tristancode/kona-3d-prints/reference/photos/front-v1-test-print.jpg

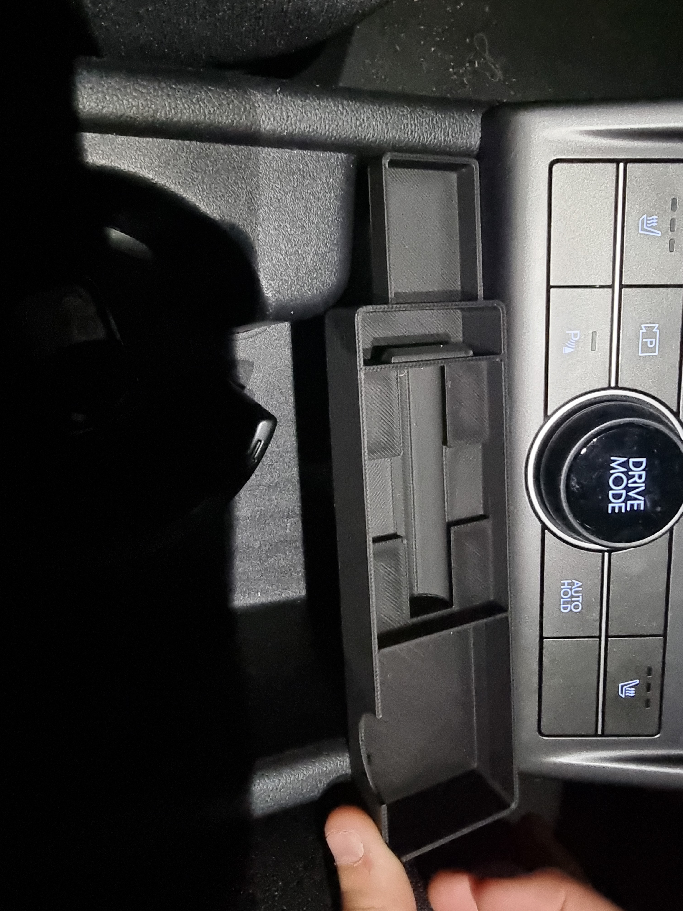
reference/photos/front-v1-test-print.jpg
