tristancode/kona-3d-prints/docs/decisions.md

# Decision log

One line per decision, in date order. The linked conversation record has the context.

| Date | Decision | Source |
|---|---|---|
| 2026-09-27 | Trays are generated from parametric CadQuery scripts; print files and pictures are outputs, never edited by hand | [rear tray conversation](conversations/2026-09-27-rear-console-tray.md) |
| 2026-09-27 | Low profile to save filament: 20 mm tall, 1.6 mm walls, 1.0 mm floor, no supports | rear tray conversation |
| 2026-09-27 | Lip balm taken as a Burt's Bees tube, 15.3 × 68 mm: 15.7 mm channel, 13.8 mm snap opening, closed ends | rear tray conversation |
| 2026-09-27 | Rear tray front is the short end Charlimit circled; two cradles across it, parallel to the front wall | rear tray conversation |
| 2026-09-27 | Rear bin floor: 190 long, 120 wide for the back 120 mm, 135 at the front; tray clearance 0.75 per side, 1.5 per end | rear tray conversation |
| 2026-09-27 | One 24 mm U finger notch behind the cradles | rear tray conversation |
| 2026-09-27 | One half-pencil lift ridge on the back of the cradle wall, nearer the middle; side tabs dropped | rear tray conversation |
| 2026-09-27 | Fob pocket 58 × 40 mm, straight sided, for a 55 × 33 mm fob | rear tray conversation |
| 2026-09-27 | Every render includes measurements on each edge | rear tray conversation |
| 2026-10-12 | Front tray locates with a tongue in the 31.0 × 39.8 mm slot; fob on the right, balm to its left | [front tray conversation](conversations/2026-10-12-front-console-tray.md) |
| 2026-10-12 | Front strip width assumed 44 mm until measured | front tray conversation |
| 2026-10-12 | One repo for all Kona prints, one folder per part, one commit per version (`<part>: vN - ...`), tagged `<part>-vN` | [repo conversation](conversations/2026-10-12-repo-setup.md) |
| 2026-10-12 | Conversations stored as records plus the visible messages, as in `pizza-oven` | repo conversation |
| 2026-10-13 | Front tray v2: overall length = caliper 156.6 + 5 = 161.6 mm; 13 mm tall throughout (lowest the balm snap allows) | [front tray conversation](conversations/2026-10-12-front-console-tray.md) |
| 2026-10-13 | Front tray: finger well removed; half-pencil lift nub on the inside of the fob pocket's outer wall | front tray conversation |
| 2026-10-16 | Front tray v3: tab 27.5 mm, 159.6 mm long; balm in an open straight-sided half-cylinder trough (no snap) against the panel side; fob floor tilted 6° to the right end | [front tray conversation](conversations/2026-10-12-front-console-tray.md) |
| 2026-10-16 | Front tray v4: both end faces taper 10° (longer at the top) instead of a tilted fob floor; grip notch through both trough walls | [front tray conversation](conversations/2026-10-12-front-console-tray.md) |
| 2026-10-16 | Front tray v5: right end angled in plan (5 mm), balm on the cupholder side with finger space at the panel, no wide strip beside the balm, end taper 5° | [front tray conversation](conversations/2026-10-12-front-console-tray.md) |
| 2026-10-16 | Front tray v6: no finger space; balm trough walls are the outer walls; one shared wall between the trough and the fob pocket | [front tray conversation](conversations/2026-10-12-front-console-tray.md) |
| 2026-10-16 | Printing: Claude slices on the user's PC but does not imitate Bambu's signed print-start; the user presses Print in Bambu Studio unless LAN Only + Developer Mode is on. The printer access code is never stored or committed | [front tray conversation](conversations/2026-10-12-front-console-tray.md) |
