tristancode/kona-3d-prints/docs/conversations/2026-10-12-front-console-tray.md

# Conversation record – front console tray v1 to v6

| | |
|---|---|
| **Dates** | 2026-10-12, 15:20 to 15:27 Sydney time (04:20 to 04:27 UTC); 2026-10-13, 16:44 to 17:00 Sydney (05:44 to 06:00 UTC); 2026-10-16, 15:43 to 17:46 Sydney (04:43 to 06:46 UTC) |
| **Area** | front tray (the strip between the cupholders and the drive-mode panel) |
| **Claude project** | "Kona 3d print organiser", thread "Front console organiser" (claude.ai, cloud session) |
| **People** | Charlimit, Claude |
| **Status** | v1 and v2 test printed. v6 printing on 2026-10-16, fit not yet checked |
| **Type** | Record (summary written by Claude, not a verbatim transcript). The visible messages are in [`raw/2026-10-12-front-console-tray.md`](raw/2026-10-12-front-console-tray.md) |

## Summary
Charlimit asked for a second organiser, similar to the rear tray, for the front of the console: the key fob holder on the right, lip balm to its left, and a tongue in the narrow space on the left so it cannot move. Four photos came with it, with caliper and tape readings (`reference/photos/front-strip-01.jpg` to `-04.jpg`).

Claude wrote it the same way as the rear tray: a CadQuery script, `front-tray/kona_front_organiser.py`, plus `render_front.py` for the 3D preview and the dimensioned top view.

Layout, left to right: a 38.3 × 29.5 × 10 mm locating tongue that drops into the slot (0.75 mm clearance each side), a 12.8 mm finger well with a half-pencil lift ridge, one snap-in lip balm cradle lying lengthways, and a 58 × 40.8 mm fob pocket with straight sides. Main body 147 × 44 × 20 mm, 185.3 mm long with the tongue.

On 2026-10-13 Charlimit test printed v1 (`reference/photos/front-v1-test-print.jpg`). The tongue went into the slot and the 44 mm width fitted, but the tray was too long. They measured the strip at 156.6 mm with the calipers (`front-strip-length-caliper.jpg`) and asked for v2: the length should be the caliper reading plus 5 mm, remove the finger pocket, put the nub on the wall of the remote section, drop the height as much as possible, and make the left section the same height as the rest.

v2 is 161.6 mm overall (123.3 mm wide section plus the 38.3 mm narrow section) and 13 mm tall throughout, which is as low as the lip balm snap allows. The finger well and the fob finger scoop are gone. The cradle now starts inside the narrow section, off-centre towards the panel side, and leaves a 27.4 mm bin at the far left. The half-pencil nub is on the inside of the fob pocket's outer long wall and protrudes 3.5 mm, leaving 37.3 mm for the 33 mm fob.

On 2026-10-16 Charlimit test printed v2 (`reference/photos/front-v2-test-print-01.jpg` to `-04.jpg`) and asked for rework: the left tab was about 2 mm too wide, the overall width was about 2 mm too long, the key fob container needed to angle to the right, and the lip balm needed to move forward for more finger space. The balm sides should also be straight. They curved in at the top, so the balm didn't fit, and should be only a half cylinder.

v3: the narrow section is 27.5 mm (1.75 mm clearance per side), and the tray is 2 mm shorter overall (159.6 mm). "Width too long" was read as the length, since the width is set by the fob pocket and the cupholder side is open floor. The balm now sits in an open half-cylinder trough with straight sides and no snap, pushed against the drive-mode-panel side (forward in the car), with about 22 mm of open floor beside it for fingers. The fob pocket floor tilts 6° down towards the right-hand end. Claude posted a decision card offering a tilt towards the panel or a diagonal pocket instead.

Charlimit then marked up the v3 top view (`reference/photos/front-v3-markup-taper.png`). They drew a U cross-section for the trough, scribbled over both trough walls at the grip notch, and drew a side view tapering at both ends. They added: "It's not the floor that needs to tilt, but the sides need to taper. See photos of how it doesn't fit on the right." v4 tapers both end faces 10° (top 159.6 mm, floor 155.0 mm), makes the fob floor flat again, and cuts the grip notch through both trough walls.

Charlimit marked up v4 (`reference/photos/front-v4-markup.png`): "Still wrong... Right hand side there is an angle on the right side, not straight. Move the lip balm down the page so there is finger space against the car, also remove the section below the lip balm, nothing will fit in it so wasted space/filament. Reduce the taper on the sides to 5 degrees." v5: the right end is angled in plan (5 mm shorter on the cupholder side, read from the red line), the balm trough is against the cupholder-side wall with 7 mm of finger space on the panel side, the tray is only 27.5 mm wide from the left end to the fob pocket, and the end tapers are 5°. The fob pocket grew to 64/59 mm so the 55 mm fob still fits; the bin shrank to 19 mm.

Charlimit then asked to remove the 7 mm finger space and use the lip balm walls to join the sections, and said the balm's right-hand wall looked separate from the fob pocket's left wall when it should be continuous so it prints correctly. v6 makes the trough's side walls the outer walls (balm section 18.9 mm wide) and gives the trough and fob pocket one shared wall.

On 2026-10-16 Charlimit asked how much PLA v6 needs (Claude estimated 16 to 19 g from the 15.1 cm³ volume) and then asked Claude to send it straight to the printer using the LAN access code. Claude started a session on Charlimit's PC, which sliced v6 in Bambu Studio's engine (P1S 0.4 mm, Generic PLA, 0.2 mm layers, 3 walls, 15% gyroid, textured PEI at 60 °C: about 29 min and 17.3 g, `sliced\kona_front_organiser_v6.gcode.3mf` on the PC). The P1S rejected a third-party print start (error 84033543) because it isn't in LAN Only + Developer Mode, and Claude would not imitate Bambu's signed commands, so Charlimit cleared an old print off the plate and pressed Print in Bambu Studio. Filament left after the print: about 799 g if 888 g was on the spool before the last 72 g print, or about 871 g if 888 g was the figure after it. The access code was not stored or committed.

## Decisions

| Date | Decision |
|---|---|
| 2026-10-12 | Read from the photos: the narrow slot is 31.0 mm across and 39.8 mm along (calipers); the main floor is about 150 mm long (tape). |
| 2026-10-12 | Assumed, not measured: the strip width. The body is 44 mm, the least that holds the 40 mm fob pocket and its walls (`BODY_W`). |
| 2026-10-12 | Assumed: the slot is at the same floor level as the strip and flush with the drive-mode-panel side (`TONGUE_OFFSET`). |
| 2026-10-12 | Same lip balm cradle and half-pencil ridge as the rear tray; one cradle. |
| 2026-10-13 | Test print: the 44 mm width and the slot tongue fit. Overall length = caliper 156.6 + 5 = 161.6 mm, as Charlimit asked (`OVERALL_L`). |
| 2026-10-13 | Height 13 mm throughout, set by the lip balm cradle (12.6 mm); left section the same height. |
| 2026-10-13 | No finger well and no scoop; the lift nub is on the inside of the fob pocket's outer long wall. |
| 2026-10-13 | Cradle runs into the narrow section to fit the shorter length; a small bin fills the rest. |
| 2026-10-16 | Narrow section 27.5 mm (`CLEAR_SLOT` 1.75); overall 159.6 mm ("width too long" read as length). |
| 2026-10-16 | Lip balm in an open half-cylinder trough with straight sides, no snap; against the panel side with open finger space beside it. |
| 2026-10-16 | v3 placeholder: fob floor tilted 6°. Replaced in v4. |
| 2026-10-16 | v4: both end faces taper 10° from vertical (top 159.6, floor 155.0); the angle is Claude's default, read from the drawing. |
| 2026-10-16 | v4: grip notch through both trough walls; fob floor flat. |
| 2026-10-16 | v5: right end angled in plan, 5 mm shorter on the cupholder side (Claude's reading of the red line). |
| 2026-10-16 | v5: balm trough against the cupholder side; finger space against the panel; no wide strip beside the trough; end taper 5°. |
| 2026-10-16 | v6: no finger space; trough side walls are the outer walls; one shared wall between the trough and the fob pocket. |
| 2026-10-16 | Printing: slice on the PC, but start the print from Bambu Studio; no imitation of Bambu's signed commands, and the access code is never stored. |

## Deliverables and versions

| Tag | Time (UTC) | What |
|---|---|---|
| front-v1 | 2026-10-12 04:26 | Script, render script, STL, 3MF, STEP, preview and dimensioned top view, README. The committed files are the originals |
| front-v2 | 2026-10-13 05:58 | 161.6 mm long, 13 mm tall, no finger well, nub in the fob pocket |
| front-v3 | 2026-10-16 05:05 | Tab 27.5 mm, 159.6 mm long, open balm trough with finger space, fob floor tilted |
| front-v4 | 2026-10-16 05:15 | Ends taper 10°, two-sided grip notch, fob floor flat |
| front-v5 | 2026-10-16 05:30 | Angled right end, balm on the cupholder side, narrow body beside the balm, 5° taper |
| front-v6 | 2026-10-16 05:25 | Finger space removed, trough walls are outer walls, shared wall with the fob pocket |

## Open questions
- Whether 5 mm is the right amount of angle on the right end.

## Follow-ups
- Check v6's fit in the car (printed 2026-10-16).
