tristancode/kona-3d-prints/docs/conversations/2026-09-27-rear-console-tray.md

# Conversation record – rear console tray v1 to v11

| | |
|---|---|
| **Dates** | 2026-09-27, 20:55 to 22:31 Sydney time (10:55 to 12:31 UTC) |
| **Area** | rear tray (the bin under the armrest) |
| **Claude project** | "Kona 3d print organiser", thread "Kona console organiser design" (claude.ai, cloud session) |
| **People** | Charlimit, Claude |
| **Status** | v11 is current. Not yet test printed or test fitted |
| **Type** | Record (summary written by Claude on 2026-10-12, not a verbatim transcript). The visible messages are in [`raw/2026-09-27-rear-console-tray.md`](raw/2026-09-27-rear-console-tray.md) |

## Summary
Charlimit asked for a centre console organiser for a 2025 Hyundai Kona, printable on a Bambu Lab printer, low to save filament, and built around a lip balm that must not roll or rattle. Seven photos of the bin floor with a tape measure came with the request.

No CAD program was available, so Claude wrote the tray as a CadQuery script (`rear-tray/kona_organiser.py`) whose numbers sit at the top, and exported STL, 3MF and STEP from it with a 3D preview render.

The design then went through ten rounds of changes in about 90 minutes:

- **v1.** 187 × 123 × 20 mm rectangle, two snap-in lip balm cradles along a long wall, a key/coin pocket, a main bay and a side card bay, finger scoops at both ends.
- **v2.** "The front is the narrowest edge", corrected to "the wide edge": cradles moved to run end to end along a long edge, key pocket at the end of the row, two bays.
- **v3.** Charlimit circled the short end on the preview (`reference/photos/rear-markup-front-end.jpg`), which settled "front" as a short end. Two cradles side by side across that end, parallel to the front wall, key pocket beside them, one big bay behind.
- **v4.** Charlimit measured the bin: 120 mm wide for the back 120 mm, widening to 135 mm at the front. Tray tapered to 118.5 → 133 mm with 0.75 mm side clearance so it wedges and cannot slide back.
- **v5.** A 24 mm U-shaped finger notch in the wall behind the cradles, down to the tube centreline.
- **v6.** Lift tabs on the left and right walls behind the cradles, 30 mm long and 10 mm above the rim.
- **v7.** Tabs removed. Two half-pencil (half-hexagon) ridges on the back of the cradle wall, where Charlimit marked (`rear-markup-lift-ridges.jpg`). The hexagon gives a 60° underside that prints without supports.
- **v8.** The right ridge removed; only the one nearer the middle stays.
- **v9.** Charlimit asked whether a 55 × 33 mm key fob fits the pocket (35 × 46 mm: it did not). With a yes, the pocket was extended to 58 mm deep, 44 to 50 mm wide following the taper. The ridge shortened to 18 mm.
- **v10.** The tapered side of the fob pocket filled in so it is a 58 × 43.5 mm rectangle. First dimensioned top view (`kona_organiser_dimensions.png`); every render from now on carries edge measurements.
- **v11.** Fob pocket narrowed to 40 mm wide (about 7 mm of play for the fob), the strip beside it filled solid.

## Decisions

| Date | Decision |
|---|---|
| 2026-09-27 | The tray is generated from one parametric CadQuery script; print files and pictures are outputs, never edited by hand. |
| 2026-09-27 | Lip balm: Burt's Bees tube taken as 15.3 × 68 mm (standard size, not measured). Channel 15.7 mm with a 13.8 mm top opening so the tube clicks in; closed ends stop it sliding. |
| 2026-09-27 | 20 mm tall, 1.6 mm walls, 1.0 mm floor, no supports, flat side down, to keep filament low. |
| 2026-09-27 | The front of the tray is the short end Charlimit circled; two cradles sit side by side across it, parallel to the front wall. |
| 2026-09-27 | Bin floor (Charlimit's measurement): 120 mm wide for the back 120 mm, tapering to 135 mm at the front, 190 mm long. Tray clearance 0.75 mm per side and 1.5 mm per end. |
| 2026-09-27 | One wide finger notch (24 mm) behind both cradles rather than several small ones. |
| 2026-09-27 | Lift by one half-pencil ridge on the back of the cradle wall, on the tray-centre side of the notch. Side tabs dropped. |
| 2026-09-27 | Fob pocket 58 × 40 mm, straight sided, for a 55 × 33 mm fob. |
| 2026-09-27 | Every render includes measurements on each edge. |

## Deliverables and versions

Each version is one commit in `rear-tray/`, named `rear: vN - ...` (tag `rear-vN` once `tools/tag-versions.sh` has been run). See "How this history was rebuilt" for which files are original.

| Tag | Time (UTC) | What changed |
|---|---|---|
| rear-v1 | 11:01 | First tray: cradles along a long wall, key pocket, main and card bays |
| rear-v2 | 11:13 | Cradles end to end along a long edge, two bays |
| rear-v3 | 11:31 | Cradles across the circled short end; one big bay |
| rear-v4 | 11:45 | Tapered to the measured bin, 118.5 → 133 mm |
| rear-v5 | 11:48 | U finger notch behind the cradles |
| rear-v6 | 11:54 | Left and right lift tabs |
| rear-v7 | 11:57 | Tabs replaced by two half-pencil ridges |
| rear-v8 | 12:00 | Right ridge removed |
| rear-v9 | 12:10 | Fob pocket 58 mm deep |
| rear-v10 | 12:25 | Fob pocket straight sided, 58 × 43.5; dimensioned drawing |
| rear-v11 | 12:30 | Fob pocket 58 × 40 |

Print settings (from the README): PLA or PETG (ASA for hot cars), 0.4 mm nozzle, 0.2 mm layers, 3 walls, 15% gyroid, no supports. About 45-55 g, estimated, not sliced.

## How this history was rebuilt
The repository was created on 2026-10-12, after the conversation, and only v11's files were still on disk. Earlier versions were rebuilt from the design session's own transcript:

- **Scripts and READMEs are exact.** Every edit the session made to `kona_organiser.py` and `README.md` (Write, Edit, `sed` and Python replacements) was replayed in order from the recorded tool calls, and a copy taken at each point a version was sent. The replayed v11 matched the files on disk byte for byte.
- **Print files and pictures for v1 to v10 are regenerated.** Each version's STL, 3MF and STEP, and its preview, were rebuilt on 2026-10-12 from that version's script with the session's own renderer. As a check, the regenerated v11 preview came out pixel-identical to the one delivered. STEP files carry a new timestamp. Small header labels that the session edited onto the v4, v6 and v8 previews afterwards were not redone.
- **v11's files are the originals** as delivered.
- **Render scripts.** v1 to v5 were rendered by inline commands, saved here as `render.py`; `render.py` (from v6) and `dims.py` (from v10) were helper files in the session's scratch folder, never delivered. In the repo they read and write in their own folder instead of the old absolute paths, and `render.py` has a default title, so `python3 render.py` works without arguments.

## Open questions
- The fit in the bin is untested; the 0.75 mm side clearance is tight. If it binds, raise `CLEAR_SIDE` to 1.0.
- The snap fit of the balm is untested: `SNAP_GAP` 14.2 if too tight, 13.4 if too loose.
- The lip balm size is the standard Burt's Bees tube, not measured.

## Follow-ups
- Test print and fit, then record the result here and in [`../decisions.md`](../decisions.md).
