tristancode/kona-3d-prints/docs/conversations/raw/2026-10-12-front-console-tray.md

# Transcript – front console tray ("Front console organiser")

Verbatim messages from the Claude project thread, in order. Times are UTC (Sydney was UTC+11).
Claude's progress checklists are left out; photo attachments are named by the file they were
saved as in `reference/photos/`.

---

**Charlimit · 2026-10-12 04:20** (photos: `front-strip-01.jpg` to `front-strip-04.jpg`)

Looking to add another similar organiser to the front of the space. Needs the keyfob holder on the right hand side, lip balm next to that on the left. It should use the narrow space on the left in the photos to stop it from moving.

**Claude · 04:20**

I'm reading the caliper and tape measurements from your photos first, then I'll lay out the fob pocket on the right and the lip balm cradle beside it.

**Claude · 04:26** (v1)

I've designed the front organiser, but one measurement is a guess: how wide the strip is between the cupholders and the drive-mode panel. Your photos don't show it, so I made the tray 44 mm wide, which is the narrowest it can be and still hold the key fob. Could you measure that width with the calipers?

**Layout, left to right:**
- A 38 x 29.5 mm tab, 10 mm tall, that drops into the narrow slot on the left. It has 0.75 mm of clearance each side, so the tray can't slide or twist.
- A small finger well with a half-pencil ridge, so you can lift that end out.
- The lip balm, lying lengthways in a snap-in cradle with closed ends.
- A 58 x 40.8 mm key fob pocket with straight sides.

The main body is 147 x 44 x 20 mm and 185 mm long including the tab. It prints with no supports.

**Measurements**
- From your photos: the slot is 31.0 x 39.8 mm (calipers), and the main floor is about 150 mm long (tape).
- My assumptions: the slot is at the same height as the main floor, and it sits against the drive-mode panel side.

Dimensioned top view: `front-tray/kona_front_organiser_dimensions.png`. The README has the print settings and the values to change.

---

**Charlimit · 2026-10-13 05:44** (photos: `front-v1-test-print.jpg`, `front-strip-length-caliper.jpg`)

Print it too long should be the calliper measurement plus 5mm. Also remove finger pocket, put the nub on the wall for the remote section, drop the height as much as possible and make the section on the left the same height as the rest

---

**Claude · 2026-10-13 05:58**

v2 is ready. It's 161.6 mm long (your 156.6 mm plus 5) and 13 mm tall all the way along, including the left section. 13 mm is as low as it can go and still have the lip balm click in.

- The finger well is gone. To make room, the lip balm cradle now starts in the narrow left section, and the space left over at the far end is a small bin.
- The half-pencil nub is on the inside of the key fob pocket's outer wall, the side away from the drive-mode panel. It sticks out 3.5 mm and the fob still fits.
- The width (44 mm) and the left section are unchanged, since those fitted.

It's committed to kona-3d-prints as front v2.

---

**Charlimit · 2026-10-16 04:43** (photos: `front-v2-test-print-01.jpg` to `front-v2-test-print-04.jpg`)

The front one needs rework, the tab on the left is too wide by about 2mm. The overall width is too long by around 2mm i think. The key fob container needs to angle to the right. The lip balm section needs to move forward to give more finder space, the sides also need to be straight, at the moment the curve around at the top so the lip balm doesn't fit in, they should only be a half cylinder, no more.

---

**Charlimit · 2026-10-16 04:48** (in reply to Claude's card asking which way the fob pocket should angle)

I will draw it

---

**Claude · 2026-10-16 05:08**

Sounds good. Send the drawing and I'll redo the fob pocket from it. Everything else is done in v3, committed as front v3:

- The left tab is 2 mm narrower (27.5 mm).
- It's 2 mm shorter overall (159.6 mm). I read "overall width" as the length, because the width is set by the fob pocket. Tell me if you meant the width and I'll take 2 mm off that instead.
- The lip balm sits in a plain half-cylinder trough with straight sides and closed ends, so nothing curves over the top. It's pushed against the drive-mode panel side, which leaves about 22 mm of open floor beside it for your fingers.
- For now the fob pocket floor tilts 6° down towards the right-hand end. Your drawing will replace that.

---

**Charlimit · 2026-10-16 04:58** (image: `front-v3-markup-taper.png`)

(drawing only, no text)

---

**Claude · 2026-10-16 04:59**

Got it: tapered ends (longer at top), U-shaped trough with a grip notch on both sides. Working on v4 now.

---

**Charlimit · 2026-10-16 04:59**

It's not the floor that needs to tilt, but the sides need to taper. See photos of how it doesn't fit on the right

---

**Claude · 2026-10-16 05:00**

Understood: the fob tilt is gone and the end walls taper in v4. Finishing the renders now.

---

**Claude · 2026-10-16 05:15**

v4 is done and committed as front v4.

- Both ends now taper 10°, so the tray is 159.6 mm long at the top and 155.0 mm at the floor. I took 10° from your drawing, so tell me if the ends need more or less lean.
- The fob pocket floor is flat again.
- The lip balm trough is a plain U with closed ends, and the grip notch now cuts through both sides.

---

**Charlimit · 2026-10-16 05:07** (image: `front-v4-markup.png`)

Still wrong, corrections in red on the screen shot. Right hand side there is an angle on the right side, not straight. Move the lip balm down the page so there is finger space against the car, also remove the section below the lip balm, nothing will fit in it so wasted space/filament. Reduce the taper on the sides to 5 degrees

---

**Claude · 2026-10-16 05:08**

Got it: angled right end, lip balm moved to the cupholder side, section below it removed, 5° tapers. Starting v5.

---

**Claude · 2026-10-16 05:30**

v5 is done and committed as front v5.

- The right end is angled, full length on the panel side and 5 mm shorter on the cupholder side. I read the 5 mm off your red line, so say if it needs more or less.
- The lip balm is against the cupholder side now, with 7 mm of finger space between it and the panel.
- The strip below the lip balm is gone. The tray is only 27.5 mm wide until the fob pocket.
- Both ends taper 5°.
- To keep the 55 mm fob fitting with the angled end, the pocket is 64 mm on the panel side and 59 mm on the cupholder side. The small bin on the left shrank to 19 mm to make room.

---

**Charlimit · 2026-10-16 05:16**

I think the "'finger space 7" can be removed, using the wall for the lip balm to join the sections. I also worry from the renders that the right hand side wall of the lip balm looks seperate from the left had wall of the key fob, they should be continuous so it prints correctly.

---

**Claude · 2026-10-16 05:17**

Understood: drop the finger space so the balm trough walls are the outer walls, and share one wall with the fob pocket. Doing v6.

---

**Claude · 2026-10-16 05:25**

v6 is done and committed as front v6.

- The finger space is gone. The lip balm trough's walls are now the outer walls joining the bin to the fob pocket, so that section is 18.9 mm wide.
- The trough's right end and the fob pocket's left side are now one shared wall, so it prints as one continuous piece. That freed 1.6 mm, so the small bin grew to 20.6 mm.
- Everything else is the same as v5.

---

**Charlimit · 2026-10-16 05:19**

How much Pla filament?

---

**Claude · 2026-10-16 05:20**

About 16 to 19 g of PLA, or roughly 5.5 to 6.5 m of 1.75 mm filament.

That comes from the model's volume of 15.1 cm³. The walls and floor are thin enough to print almost solid, so 19 g is the upper limit at 100% fill. The infill only saves a little, around the thicker trough walls. Bambu Studio will give you the exact figure once you slice it.

---

**Charlimit · 2026-10-16 06:28**

push to the printer. In one of the other messages you said there was a key that could be used to print directly, can we do that?

---

**Claude · 2026-10-16 06:29**

You want v6 sent straight to your printer. I'll find the earlier message about the key first.

---

**Claude · 2026-10-16 06:29**

Yes, we can. The "key" is the printer's LAN access code. I can't reach your printer from here, so the job has to run on your computer.

I've posted a card asking to work in your 3d-prints folder on Nick-DellXPS15. Once you allow it, that session will slice v6 with PLA, check the camera to make sure the plate is clear, and send the job over LAN. It will ask you for the printer's IP address and access code, which are on the printer screen under the network or LAN settings. It will also check with you once more right before printing starts.

---

**Charlimit · 2026-10-16 06:30**

details for the printer should be in bambu studio

---

**Claude · 2026-10-16 06:31**

Thanks. The session on your computer has your message too, and it will take the IP address and access code from Bambu Studio instead of asking you.

---

**Charlimit · 2026-10-16 06:33**

how much filament will be left after this print?

---

**Claude · 2026-10-16 06:33**

I can't see your spool from here. The session on your computer is asking the printer how much is left, if it has an AMS that tracks it. I'll take the roughly 17 g this print uses off that figure and let you know.

---

**Claude · 2026-10-16 06:34**

Two things are needed from you before it prints.

1. **Clear the plate.** The camera shows a light-coloured object near the back of the bed, probably the enclosure top shell from your last print. Take it off, check the textured PEI plate is seated, and reply "plate clear".
2. **Start the print.** Your P1S won't accept a print start from my tools unless Developer Mode is on, so the quickest way is to open `C:\Users\Tristan\code\3d-prints\sliced\kona_front_organiser_v6.gcode.3mf` in Bambu Studio and press Print. If you'd rather I start it, turn on LAN Only + Developer Mode on the printer. That disconnects Bambu Handy and the cloud.

It's sliced for the P1S with black PLA on the external spool: about 29 minutes and 17.3 g. I can't tell you how much filament will be left, because the external spool doesn't report what's on it. If you know the spool's weight, take 17.3 g off that.

---

**Charlimit · 2026-10-16 06:35**

previous conversation worked out how much was left, 888+72 was the last used from memory. I thought you would use the key to print directly, emulating the bambu software

---

**Claude · 2026-10-16 06:35** (edited)

**Filament:** if 888 g was left before your last 72 g print, you'll have about 799 g after this one. If 888 g and 72 g were both used from a 1 kg spool, only about 23 g is left. That's still enough for this 17.3 g print, but only just.

**Printing directly:** I did try that with the access code. Your P1S's firmware rejects a print start from anything that isn't Bambu's own app (error 84033543), even with the correct code. The only ways around it are:
- Press Print on the sliced file in Bambu Studio. This is the quickest.
- Turn on LAN Only + Developer Mode on the printer so I can start it. You'd also need to allow file uploads in Claude's permission settings on your PC, because uploading the file to the printer was blocked there.

**Plate:** a fresh camera snapshot still shows the light-coloured object near the back of the bed, so take it off before printing.

---

**Claude · 2026-10-16 06:46**

v6 is printing now, with about 29 minutes to go. Thanks for clearing the plate and pressing Print.

If 888 g was on the spool before your last 72 g print, you'll have about 799 g left after this one. If 888 g was already the figure after that print, it'll be about 871 g.

Send a photo once it's in the car and I'll make any fit tweaks.
