tristancode/kona-3d-prints/docs/conversations/raw/2026-09-27-rear-console-tray.md

# Transcript – rear console tray ("Kona console organiser design")

Verbatim messages from the Claude project thread, in order. Times are UTC (Sydney was UTC+10).
Short acknowledgement lines from Claude and its progress checklists are left out; photo
attachments are named by the file they were saved as in `reference/photos/`.

---

**Charlimit · 2026-09-27 10:55** (photos: `rear-bin-01.jpg` to `rear-bin-07.jpg`)

Using the photos and available info for a kona 2025, design a center console organiser that can be printed on a bamboo labs printer. The print should be fairly low to reduce filament usage, and prioritise the storage of the shown lip balm that also prevents it from rolling and making noise.

**Claude · 11:01** (v1)

I've designed the organiser and exported it. It's a low tray, 187 × 123 × 20 mm, that sits on the grey floor of the console bin.

**Lip balm:** there are two cradles along one long wall. The opening at the top is 13.8 mm wide and the tube is about 15.3 mm, so the balm clicks in and can't roll. Closed ends stop it sliding back and forth, which is what makes the noise. A finger notch in the middle lets you pull it out.

**Other storage:** a small key/coin pocket, a main bay about 110 mm long for a phone or wallet, and a side bay for cards. Both short ends have a finger scoop so you can lift the tray out.

**Measurements I used:** from your photos I read the floor as about 19 cm along the car and about 13 cm across. It narrows to about 12 cm near the rubber mat. The lip balm size (15.3 × 68 mm) comes from the standard Burt's Bees tube, not from your photos. I shrank the tray 1.5 mm per side lengthwise and 3.5 mm per side across so it fits past the narrow end.

**Printing:** use PLA or PETG with 0.2 mm layers, 3 walls, 15% infill and no supports. PETG copes better if the car gets hot. I estimate about 50 g, but check your slicer's figure. I haven't sliced it or test-fitted it in the car.

If the tray is too tight in the bin or the balm clicks in too hard, change the numbers at the top of `kona_organiser.py` and run it again. The README lists which setting to change for each fix.

**Charlimit · 11:10**

the limb balm storage needs to be at the front of the container, at the moment it would be at the side. The front is the narrowest edge

**Claude · 11:10**

Got it. I'll move the lip balm cradles to the narrow front edge and turn them to lie parallel to it.

**Charlimit · 11:12**

sorry it should be the wide edge

**Claude · 11:13** (v2)

The updated files are attached. The two lip balm cradles now run end to end along the wide front edge, and the key pocket is at the end of that row. The cradles no longer run into the rounded corner, and the tray is still 187 × 123 × 20 mm. The main area has two bays, one for cards and odds and ends and one for a phone or wallet.

The tray only fits the bin one way, so drop it in with the cradle edge facing the front of the car.

**Charlimit · 11:29** (marked-up preview, no text: `rear-markup-front-end.jpg`)

**Claude · 11:31** (v3)

The lip balm cradles are now at the end you circled. The files and preview are updated, and the preview uses the same angle as your markup.

At that front end there are two snap-in cradles side by side, each lying parallel to the front wall, with a key/coin pocket next to them. The rest of the tray is one big bay that fits a phone. The size is unchanged at 187 × 123 × 20 mm.

If the front of the bin is actually wider than the back, tell me and I can taper the tray to match. Right now it's a plain rectangle.

**Charlimit · 11:43**

I am worried that as it is not tapered from the middle to the front that it will shift. It tapers starting at ~12cm from the back, from 12cm wide to 13.5cm wide

**Claude · 11:45** (v4)

The tray is now tapered to your measurements. The files and preview are updated.

It's 118.5 mm wide along the back 12 cm, then widens to 133 mm at the front. That leaves only about 0.75 mm of gap per side, so the taper wedges it in and it can't slide backwards. The length is still 187 mm, and the lip balm cradles and key pocket stay at the front.

The fit is tight, so a test print is worth doing before you print it for real. If it binds, raise `CLEAR_SIDE` at the top of `kona_organiser.py` from 0.75 to 1.0.

**Charlimit · 11:47**

Add a set of notches behind the lip balm section so you can easily pull it out

**Claude · 11:48** (v5)

I've added the notch and updated the files and preview. There's a 24 mm U-shaped notch in the wall behind the lip balm section, cut down to the middle of the tubes. It lines up with the finger gaps in both cradles, so you can reach in from the main bay and lift a balm straight out.

I did one wide notch rather than several small ones, because the two cradles sit side by side and share the same finger gap. If you'd like more notches, or this one wider or deeper, tell me the size.

**Charlimit · 11:52**

On the left and the right behind the lip balm I want a bump that can be used to lift up

**Claude · 11:54** (v6)

I've added the lift tabs and updated the files and preview. There's a rounded tab on the left and right walls just behind the lip balm section. Each one is 30 mm long, sticks up 10 mm above the rim, and is 3.2 mm thick so it won't snap when you lift.

The tabs sit inside the outer wall line, so the fit in the bin is unchanged. The tray is now 30 mm tall at the tabs and 20 mm everywhere else. It still prints flat with no supports.

**Charlimit · 11:56** (marked-up preview: `rear-markup-lift-ridges.jpg`)

I want the bumps on the back where indicated, remove the other ones and put them here they should be the shape of half a pencil

**Claude · 11:57** (v7)

I've taken off the side tabs and put the bumps where you marked. The files and preview are updated.

There are now two half-pencil ridges on the back of the wall behind the lip balm, one on each side of the finger notch. Each is 22 mm long, sticks out 4 mm and sits just below the top edge, so you can hook a finger under it to lift the tray. I used the six-sided pencil shape because the underside then slopes at 60°, which prints without supports. A fully round ridge would need supports underneath.

The tray is back to 20 mm tall all over.

**Charlimit · 11:59**

Remove the right Ridge leaving only the middle one

**Claude · 12:00** (v8)

I've removed the right ridge, so only the one nearer the middle is left, just to the left of the finger notch in the close-up. The files and preview are updated.

**Charlimit · 12:06** (photo: `key-fob.jpg`)

Will a keyfob fit in the change draw 3cm by 5.5cm

**Claude · 12:07**

No, not as it's drawn now. The key/coin pocket is about 35 × 46 mm and 19 mm deep. Your fob measures about 55 × 33 mm, and I read the same from your photo, so the 55 mm length is about 9 mm too long for the pocket. Standing it on end won't work either, because it would stick out well above the rim.

I can make the pocket deeper by moving part of its back wall into the main bay, to about 58 × 46 mm. The fob would then lie flat with a little room around it, and the main bay would lose that small corner. Should I go ahead?

**Charlimit · 12:09**

yes

**Claude · 12:10** (v9)

The key pocket now runs 58 mm back from the front wall. It's 44 mm wide at its narrowest and 50 mm at the front, and still 19 mm deep. Your 55 × 33 mm fob will lie flat in it with a few millimetres to spare. The files and preview are updated.

The finger notch is unchanged. The lift ridge is now 18 mm long instead of 22 mm, because the wall it sits on got shorter.

**Charlimit · 12:22**

For the fob compartment, fill in the taper so it doesn't move around. When you next do a render add measurements for each edge

**Claude · 12:25** (v10)

The fob pocket is now a straight-sided rectangle, 58 × 43.5 mm. The tapered wall beside it is filled in, so the pocket no longer widens towards the front. The files and 3D preview are updated.

I've also added a top-view drawing with measurements. Red numbers are the outer edges: 118.5 mm back, 133.2 mm front, 118.5 mm straight sides, 68.9 mm tapered sides and 187 mm overall. Green numbers are the inside spaces: the main bay, the balm channels and the fob pocket.

Your fob is 33 mm wide, so it still has about 10 mm of side-to-side play in the 43.5 mm pocket. If you want it snug, I can narrow the pocket to about 35 mm.

**Charlimit · 12:29**

For the fob, tighten up the  the size to 40mm so there is less play with the fob in place

**Claude · 12:30** (v11)

The fob pocket is now 58 × 40 mm, so your 33 mm wide fob has about 7 mm of side play instead of 10 mm. The strip between the pocket and the outer wall is filled solid, which adds about 5 g of filament. The files, preview and measurement drawing are updated.
