tristancode/kona-3d-prints/docs/conversations/README.md

# Conversation records

One file per Claude conversation: summary, dated decisions, deliverables and open questions.
These are records written by Claude, not verbatim transcripts. The visible messages of each
conversation are kept word for word in [`raw/`](raw).

| Start | Topic | Area | Record |
|---|---|---|---|
| 2026-09-27 | Rear console tray v1 to v11: lip balm cradles, taper to the bin, finger notch, lift ridge, key fob pocket | rear tray | [2026-09-27-rear-console-tray.md](2026-09-27-rear-console-tray.md) |
| 2026-10-12 | Front console tray v1: locating tongue in the narrow slot, lip balm, key fob pocket | front tray | [2026-10-12-front-console-tray.md](2026-10-12-front-console-tray.md) |
| 2026-10-12 | This repository: every version of both trays as git history, plus these records | repo | [2026-10-12-repo-setup.md](2026-10-12-repo-setup.md) |
