tristancode/kona-3d-prints/front-tray/kona_front_organiser_dimensions.png

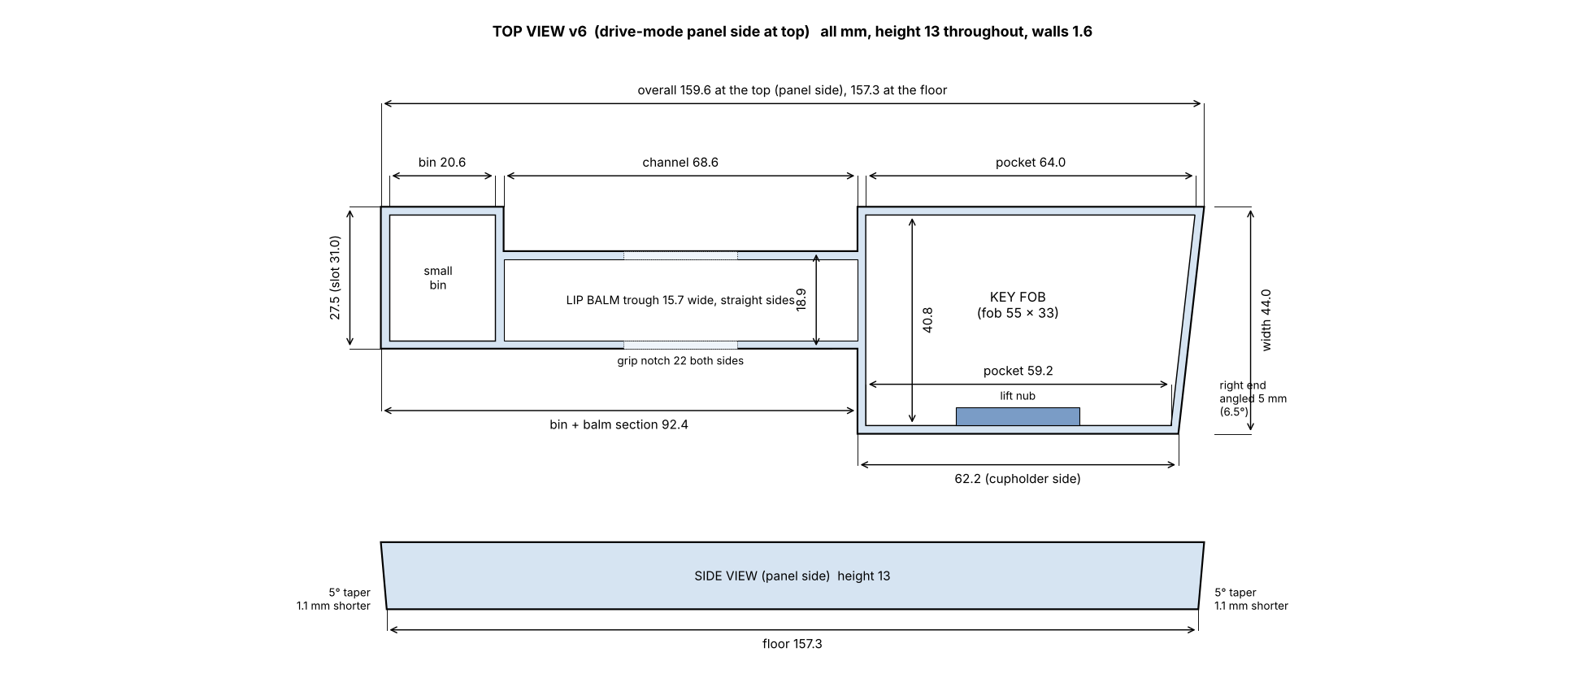
front-tray/kona_front_organiser_dimensions.png
