tristancode/kona-3d-prints/front-tray/kona_front_organiser_preview.png

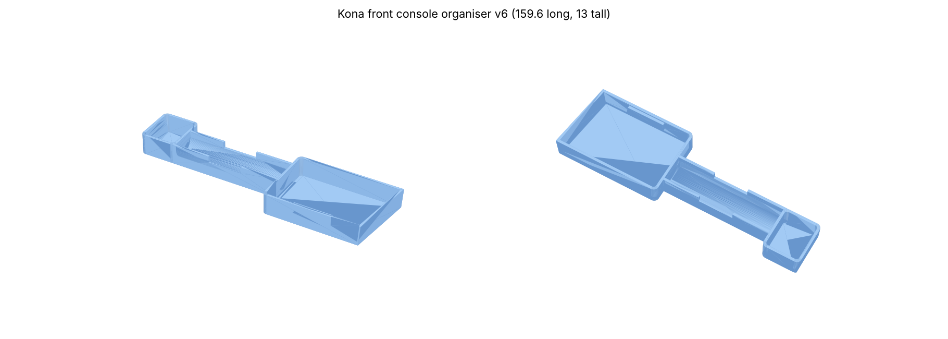
front-tray/kona_front_organiser_preview.png
