tristancode/kona-3d-prints/rear-tray/kona_organiser_dimensions.png

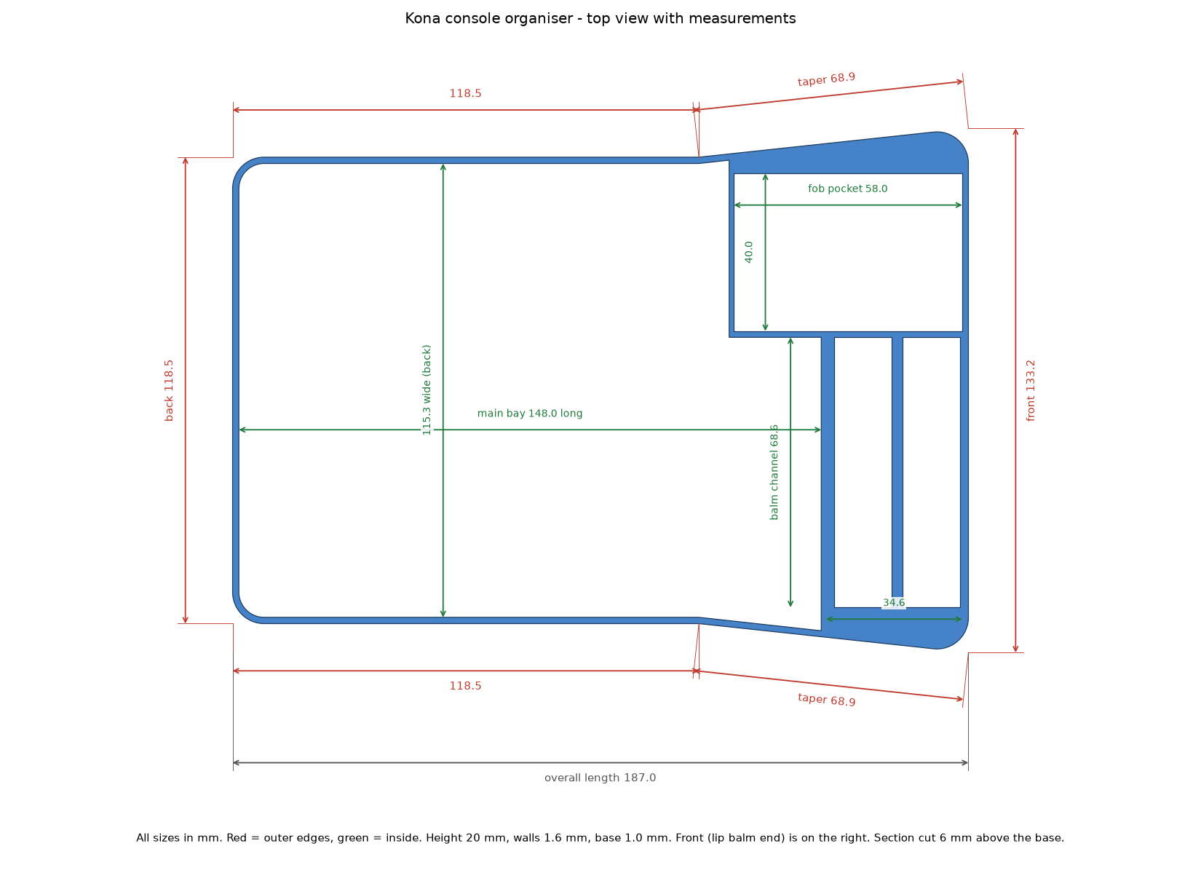
rear-tray/kona_organiser_dimensions.png
