tristancode/kona-3d-prints/rear-tray/kona_organiser_preview.png

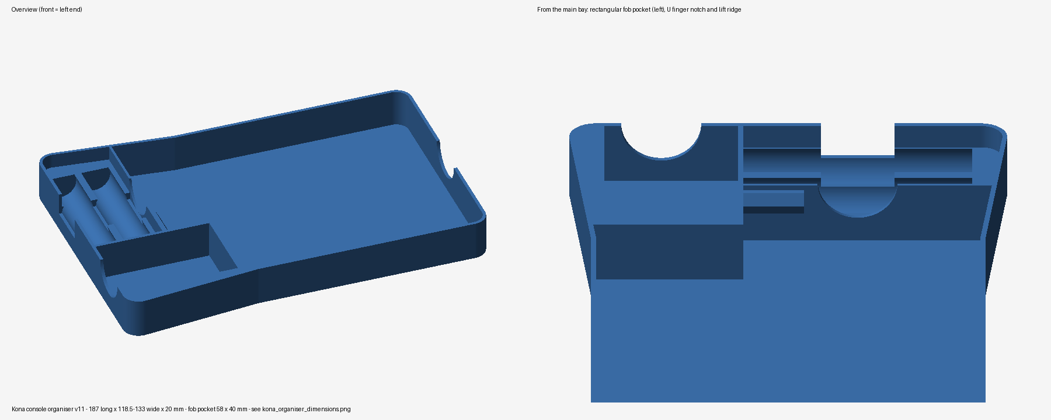
rear-tray/kona_organiser_preview.png
