tristancode/kona-3d-prints/reference/photos/front-strip-02.jpg

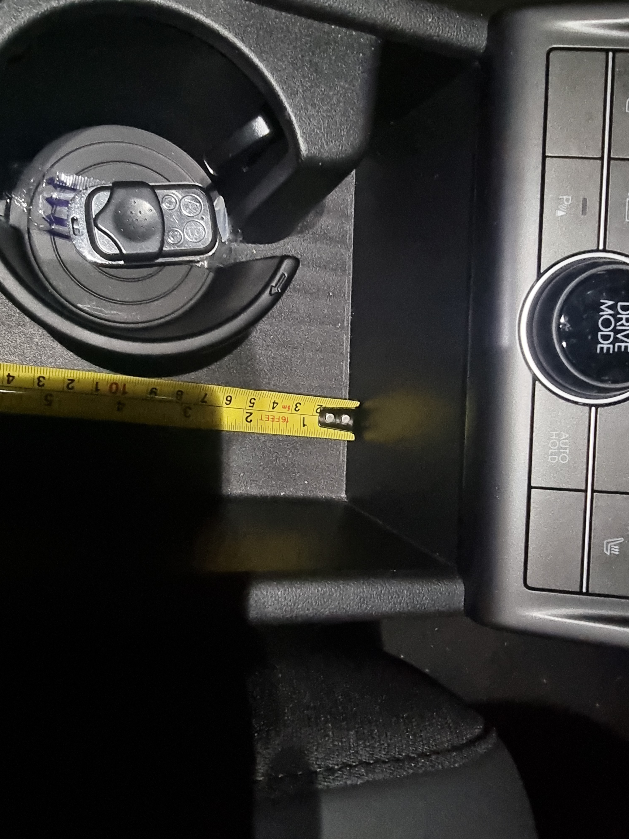
reference/photos/front-strip-02.jpg
