tristancode/kona-3d-prints/reference/photos/front-strip-03.jpg

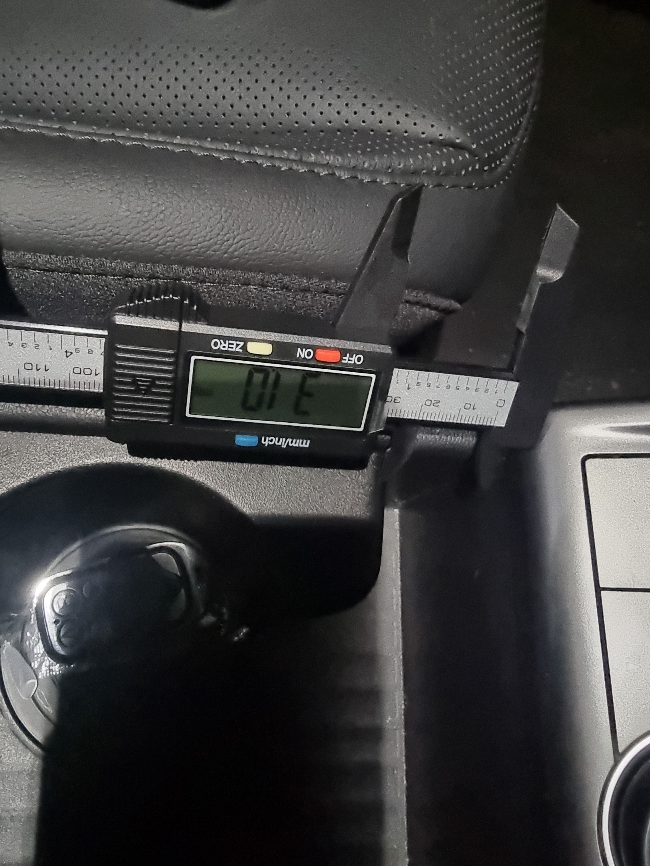
reference/photos/front-strip-03.jpg
