tristancode/kona-3d-prints/reference/photos/front-strip-04.jpg

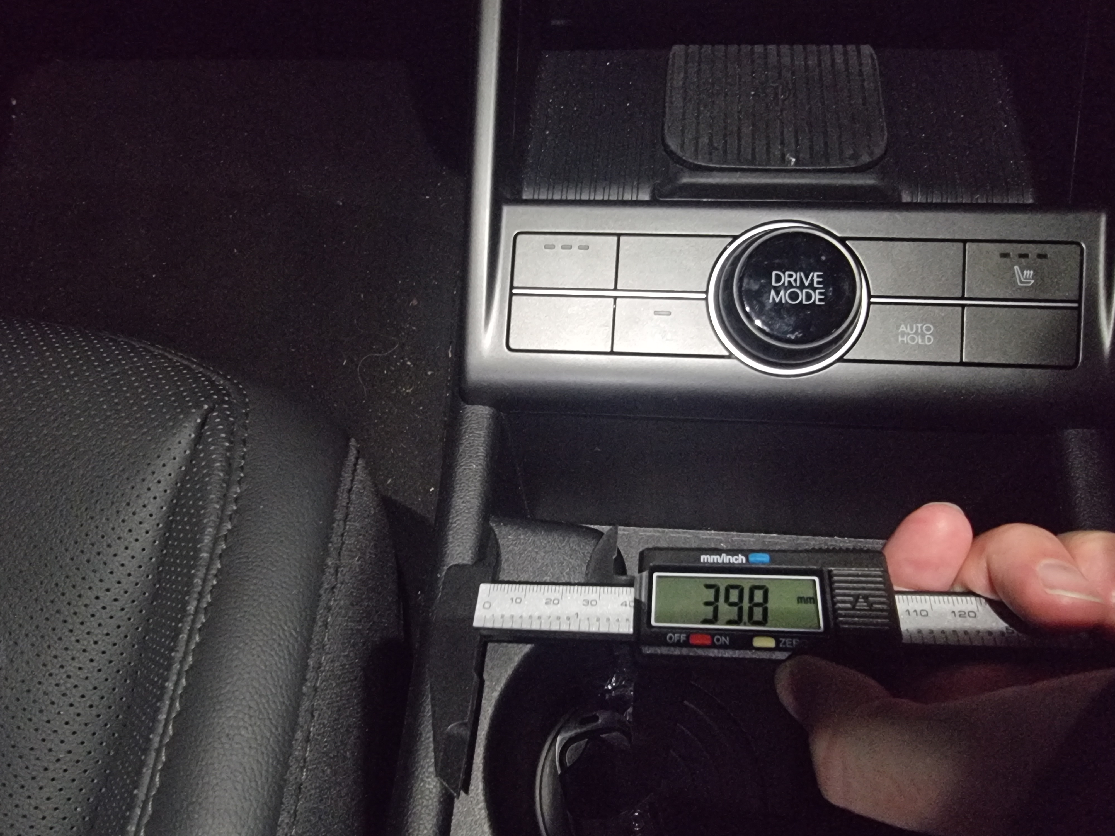
reference/photos/front-strip-04.jpg
