tristancode/kona-3d-prints/reference/photos/front-strip-length-caliper.jpg

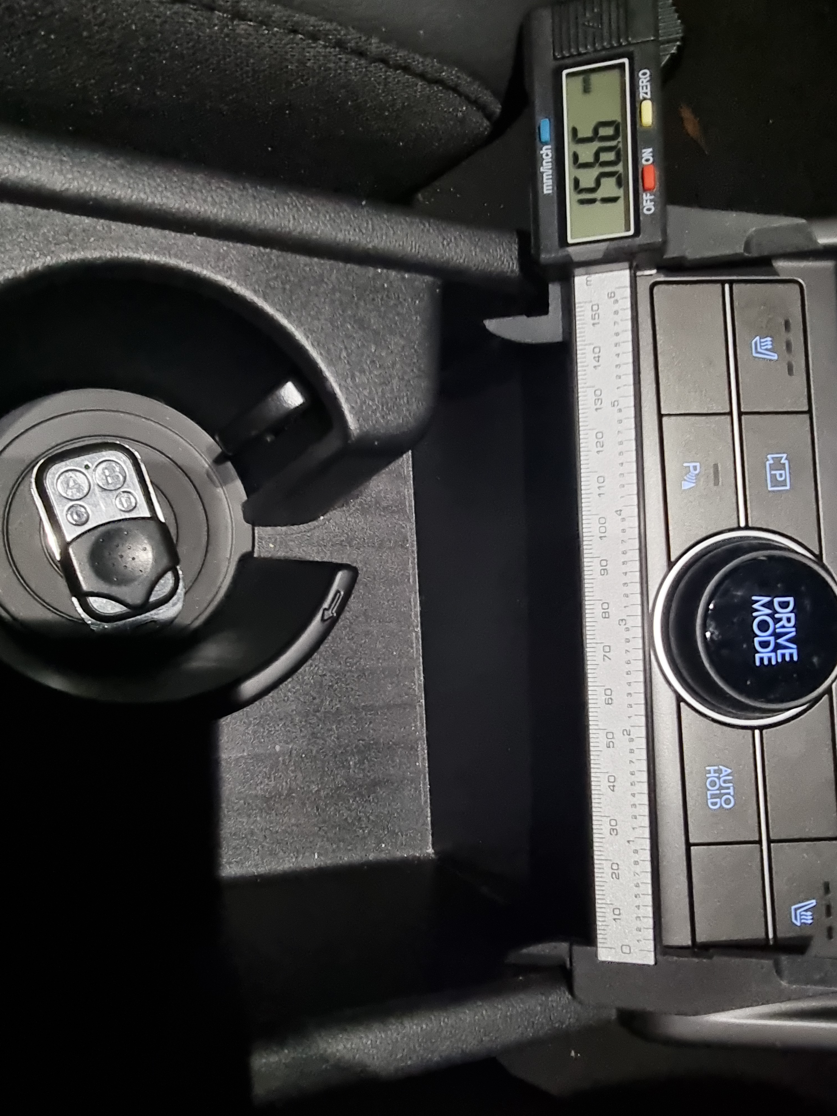
reference/photos/front-strip-length-caliper.jpg
