tristancode/kona-3d-prints/reference/photos/front-v3-markup-taper.png

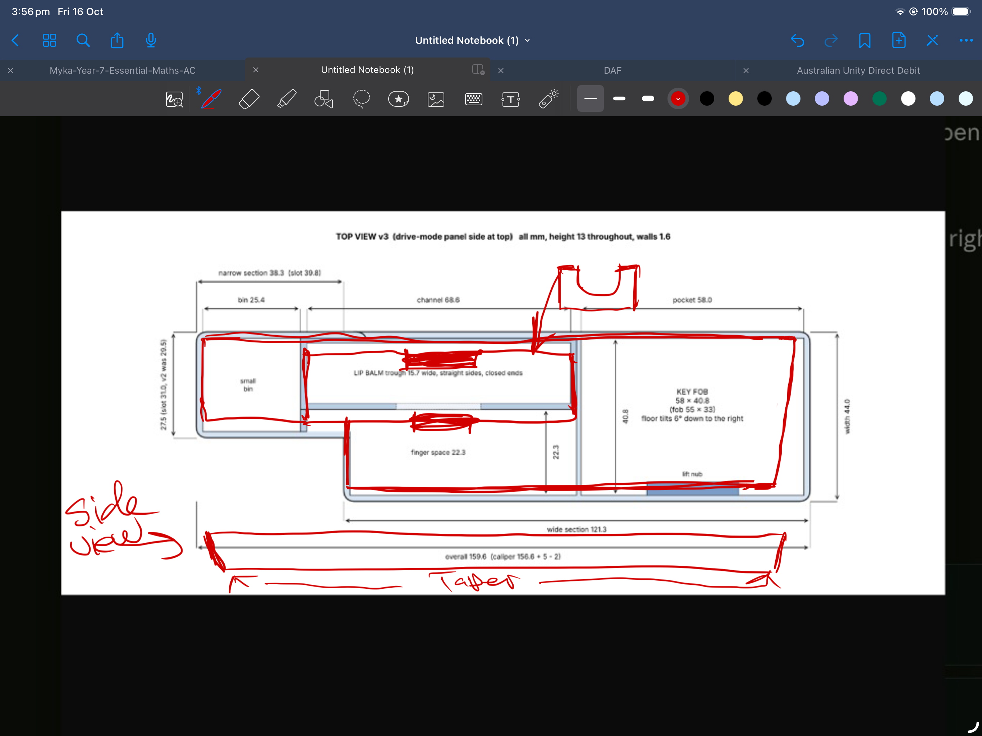
reference/photos/front-v3-markup-taper.png
