tristancode/kona-3d-prints/reference/photos/front-v4-markup.png

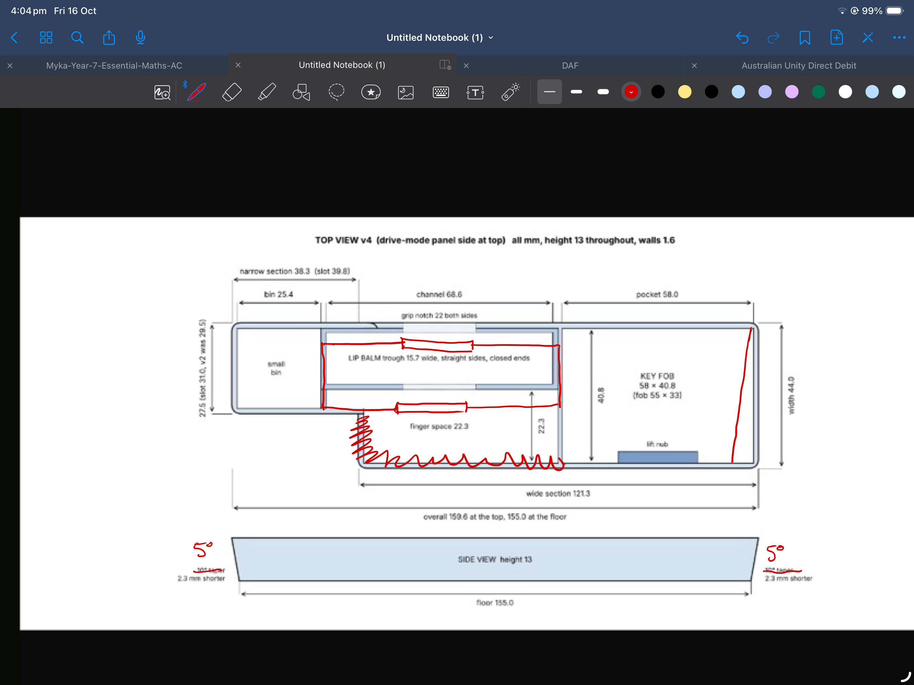
reference/photos/front-v4-markup.png
