tristancode/kona-3d-prints/reference/photos/key-fob.jpg

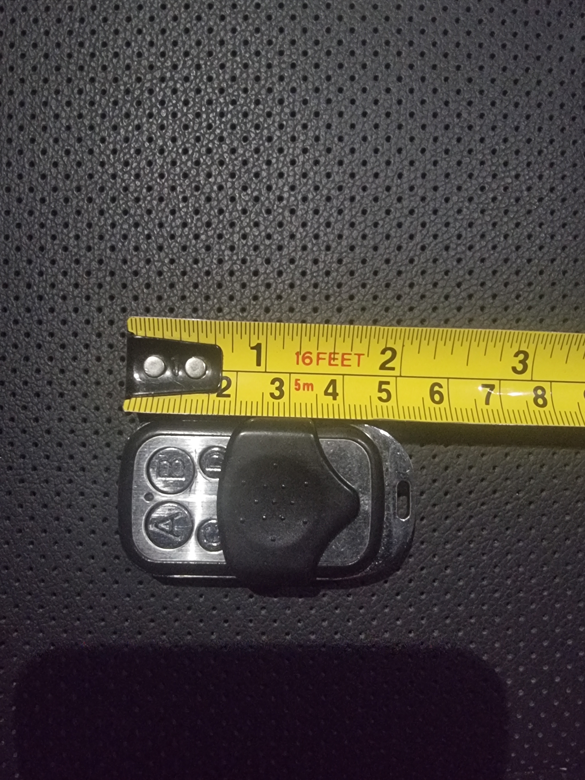
reference/photos/key-fob.jpg
