tristancode/kona-3d-prints/reference/photos/rear-bin-01.jpg

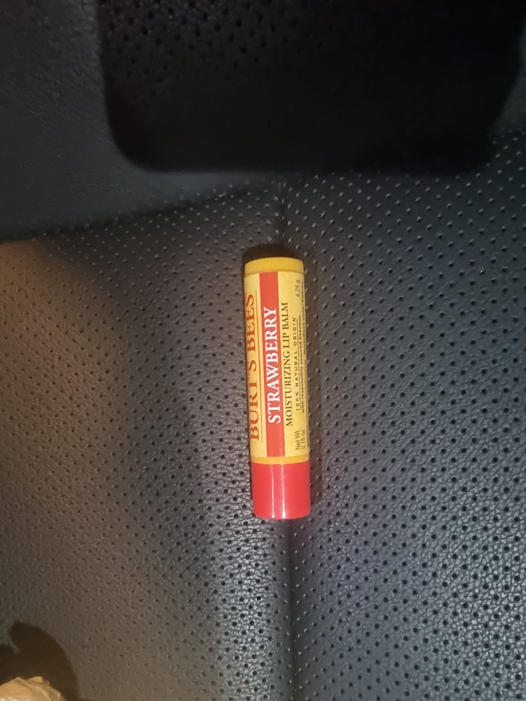
reference/photos/rear-bin-01.jpg
