tristancode/kona-3d-prints/reference/photos/rear-bin-02.jpg

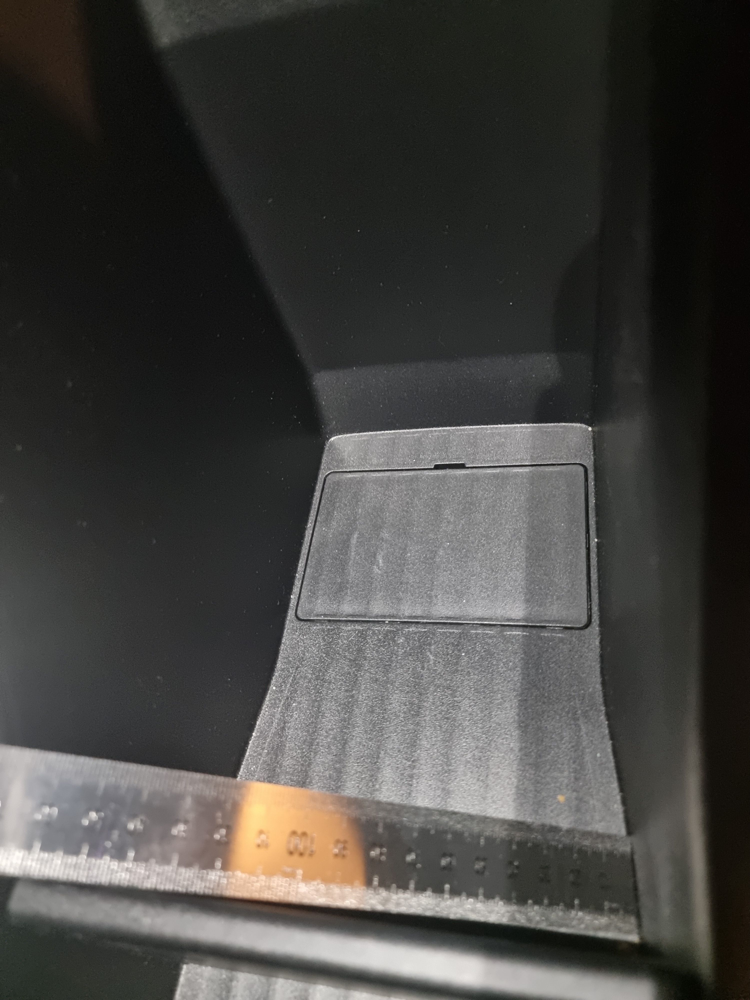
reference/photos/rear-bin-02.jpg
