tristancode/kona-3d-prints/reference/photos/rear-bin-03.jpg

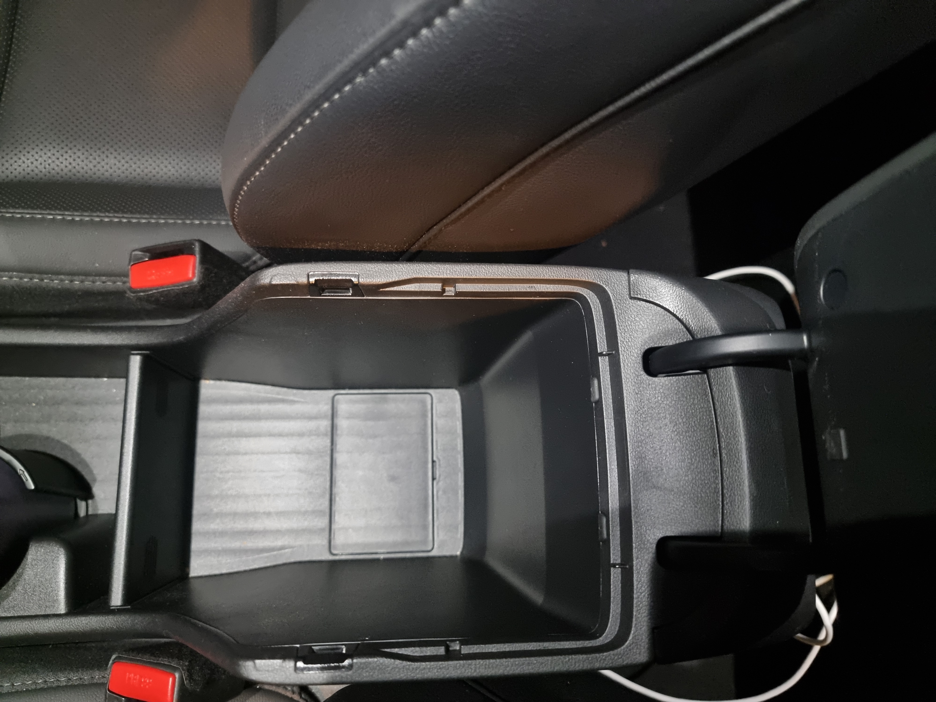
reference/photos/rear-bin-03.jpg
