tristancode/kona-3d-prints/reference/photos/rear-bin-04.jpg

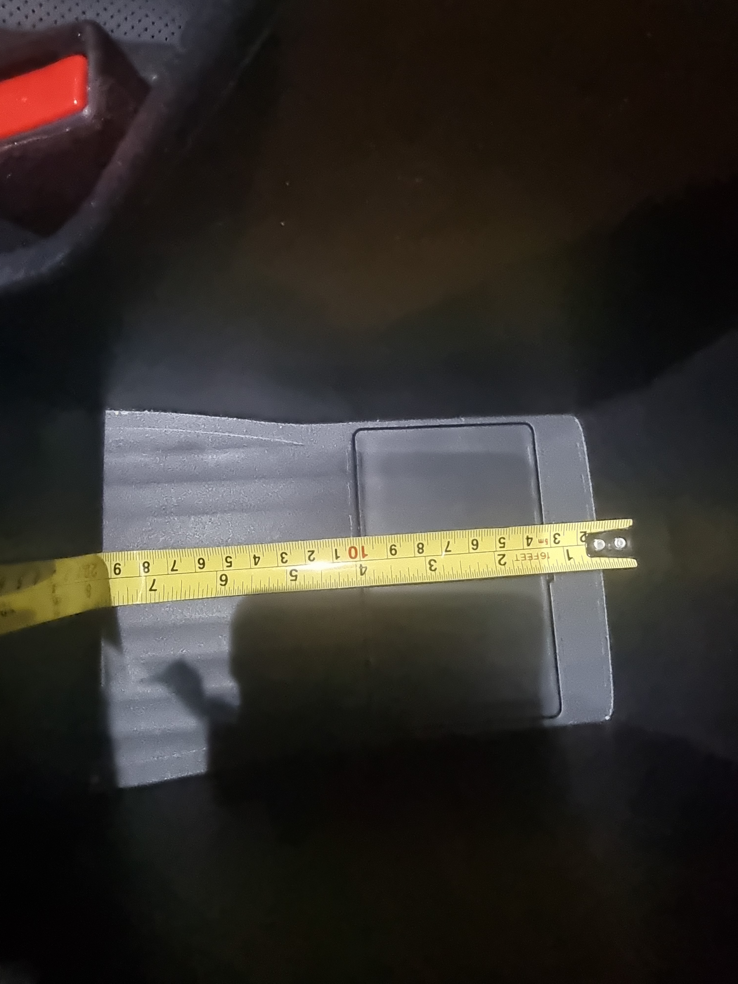
reference/photos/rear-bin-04.jpg
