tristancode/kona-3d-prints/reference/photos/rear-bin-05.jpg

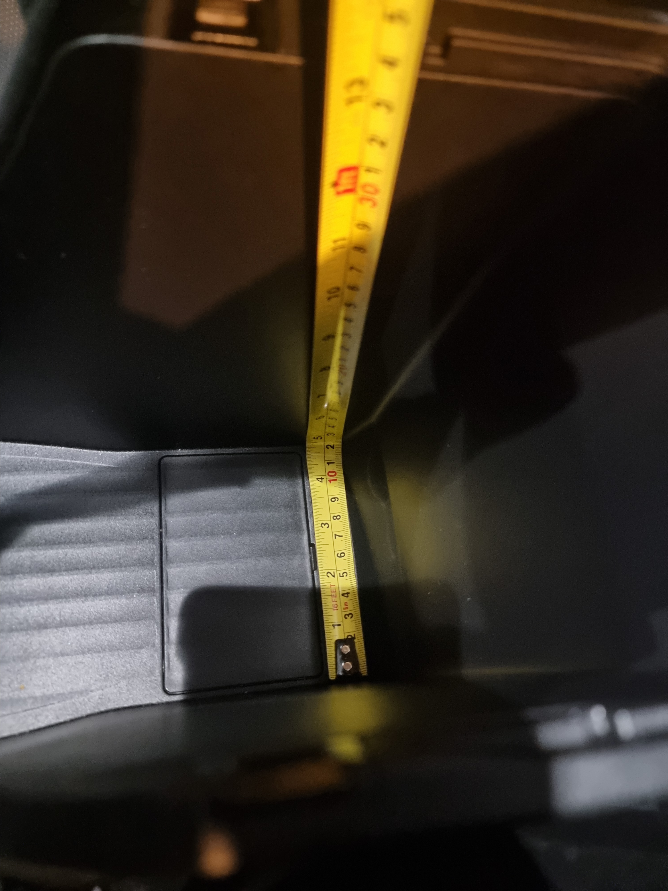
reference/photos/rear-bin-05.jpg
