tristancode/kona-3d-prints/reference/photos/rear-bin-06.jpg

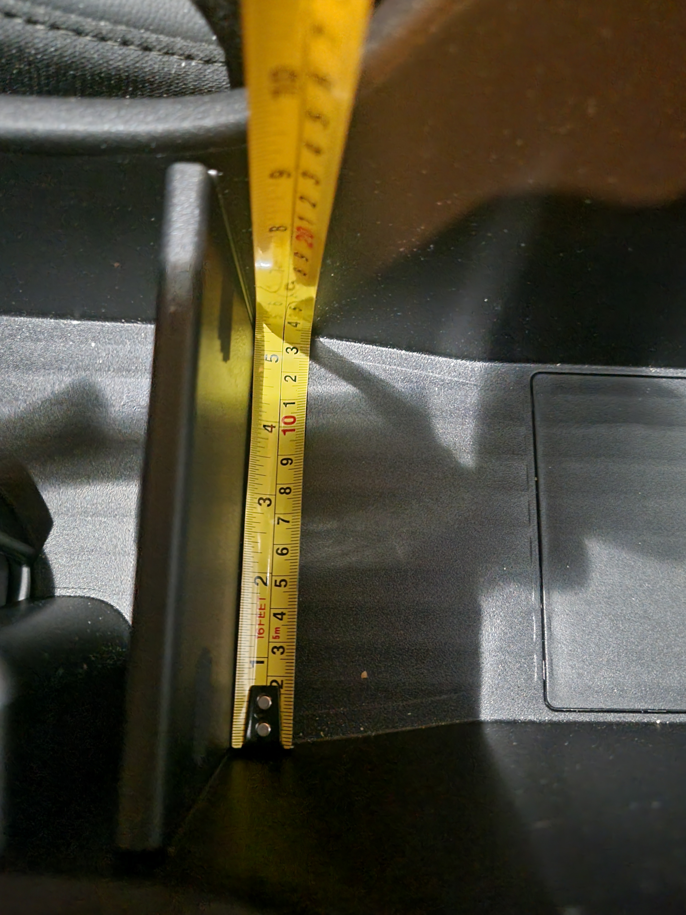
reference/photos/rear-bin-06.jpg
