tristancode/kona-3d-prints/reference/photos/rear-bin-07.jpg

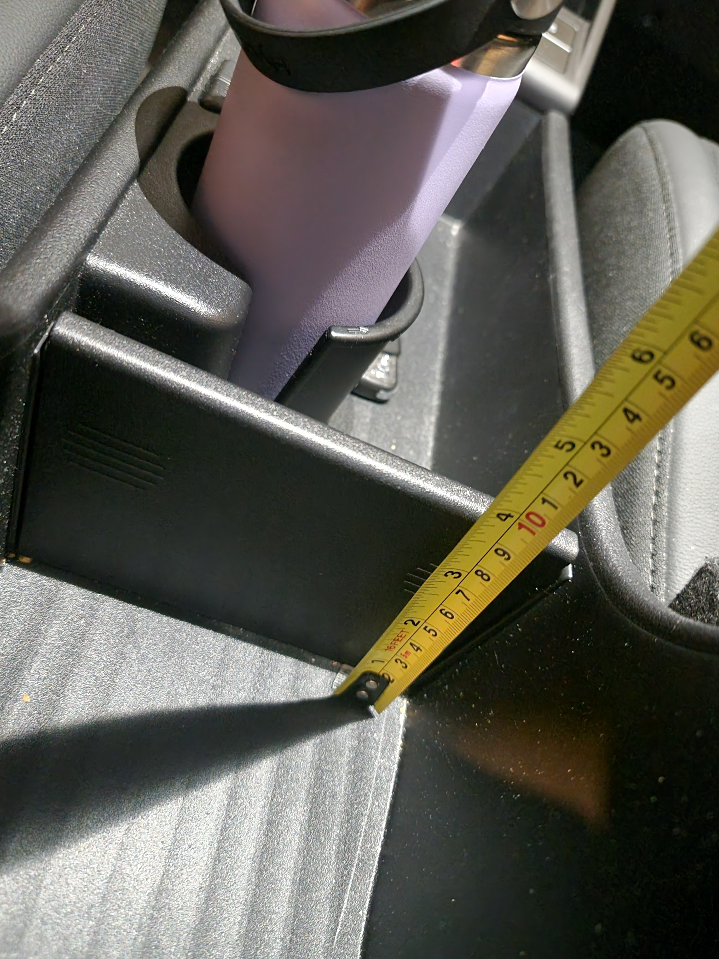
reference/photos/rear-bin-07.jpg
