tristancode/kona-3d-prints/reference/photos/rear-markup-front-end.jpg

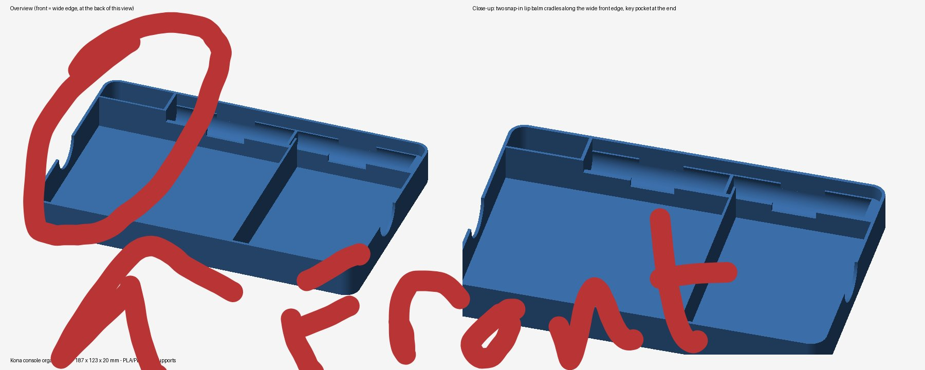
reference/photos/rear-markup-front-end.jpg
