tristancode/kona-3d-prints/reference/photos/rear-markup-lift-ridges.jpg

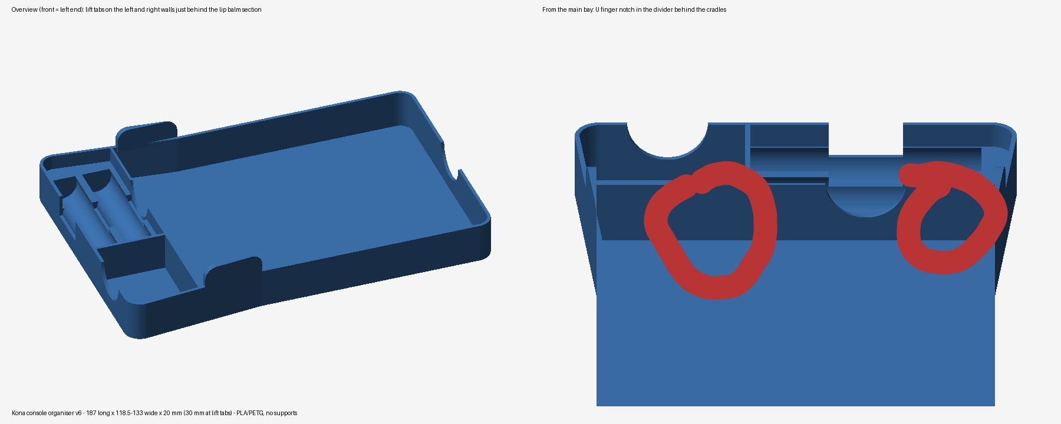
reference/photos/rear-markup-lift-ridges.jpg
