tristancode/kona-3d-prints/front-tray/kona_front_organiser.step

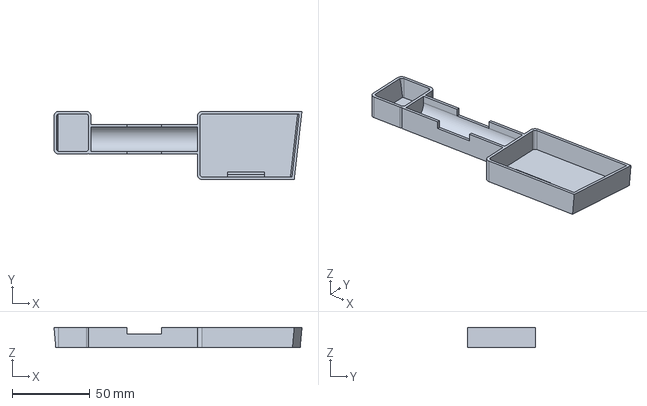
[picture p24: CAD file, 2026-10-16]
front-tray/kona_front_organiser.step
159.6 x 44.0 x 13.0 mm
