tristancode/kona-3d-prints/rear-tray/kona_organiser.step

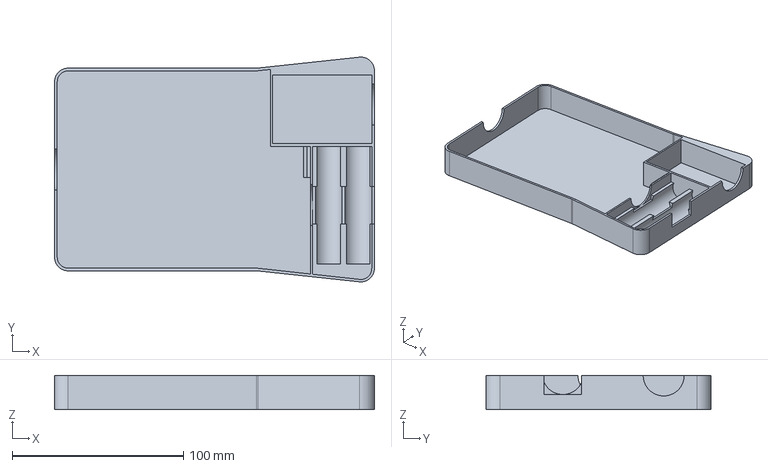
[picture p25: CAD file, 2026-09-27]
rear-tray/kona_organiser.step
187.0 x 131.4 x 20.0 mm
