tristancode/kona-3d-prints/(list of files, cad)

Other CAD files:
front-tray/kona_front_organiser.3mf
front-tray/kona_front_organiser.stl
rear-tray/kona_organiser.3mf
rear-tray/kona_organiser.stl
