tristancode/kona-3d-prints/reference/photos/front-v2-test-print-01.jpg

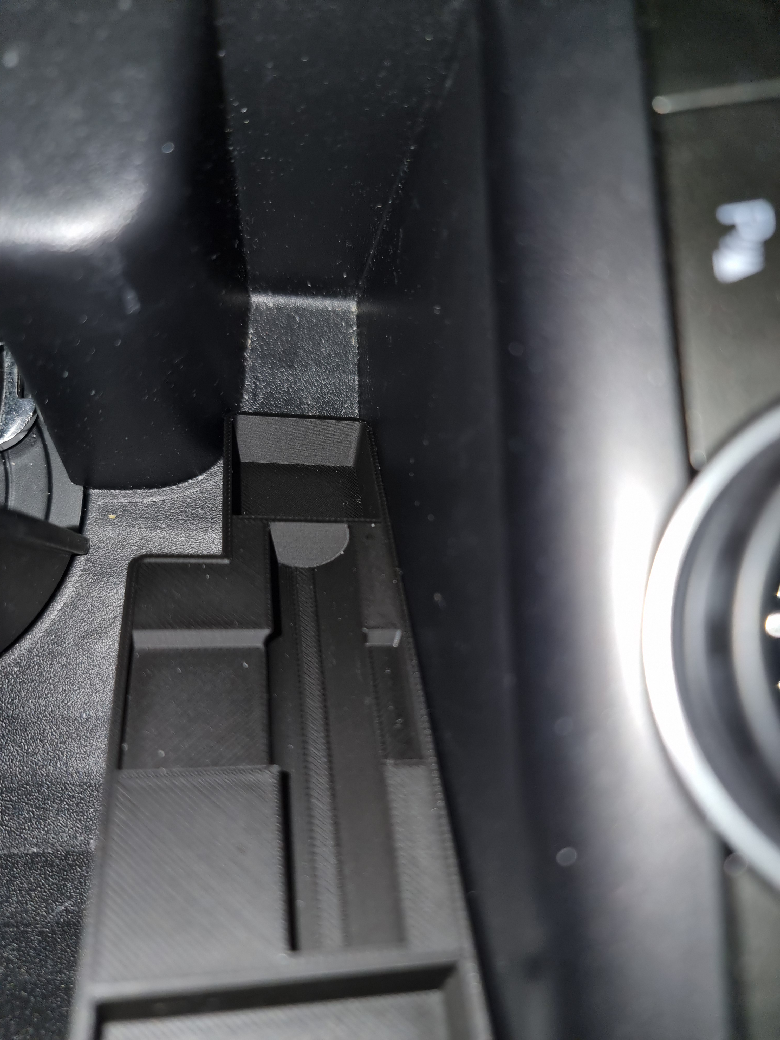
reference/photos/front-v2-test-print-01.jpg
