tristancode/kona-3d-prints/reference/photos/front-v2-test-print-04.jpg

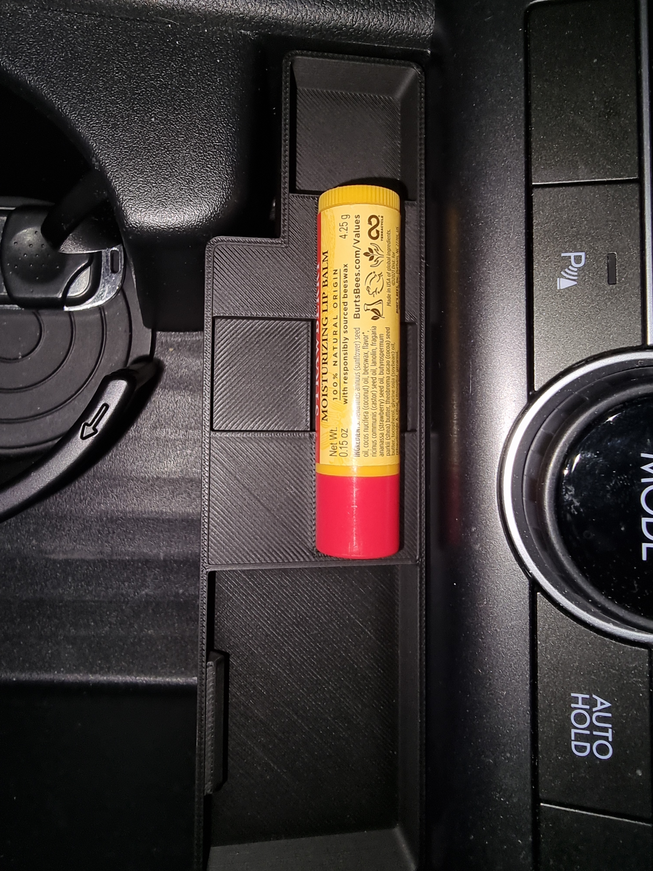
reference/photos/front-v2-test-print-04.jpg
