tristancode/kona-3d-prints/(commit log)

2026-09-27 rear: v1 - first tray, 187 x 123 x 20, two lip balm cradles along a long wall
    Rebuilt from the design session's transcript: script and README exact; STL, 3MF, STEP and preview regenerated on 2026-10-12.
    Claude-Session: https://claude.ai/code/session_01TyNMQgnZWrwVm126hWLBVZ
    [kona_organiser.3mf, kona_organiser.step, kona_organiser.stl]
2026-09-27 rear: v2 - cradles end to end along the wide edge, key pocket at the end of the row
    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
    [kona_organiser.3mf, kona_organiser.step, kona_organiser.stl]
2026-09-27 rear: v3 - cradles side by side across the circled short end, one big bay
    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
    [kona_organiser.3mf, kona_organiser.step, kona_organiser.stl]
2026-09-27 rear: v4 - taper to the measured bin, 118.5 to 133 wide
    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
    [kona_organiser.3mf, kona_organiser.step, kona_organiser.stl]
2026-09-27 rear: v5 - U finger notch behind the cradles
    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
    [kona_organiser.3mf, kona_organiser.step, kona_organiser.stl]
2026-09-27 rear: v6 - lift tabs on the left and right walls
    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
    [kona_organiser.3mf, kona_organiser.step, kona_organiser.stl]
2026-09-27 rear: v7 - side tabs replaced by two half-pencil ridges
    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
    [kona_organiser.3mf, kona_organiser.step, kona_organiser.stl]
2026-09-27 rear: v8 - right ridge removed
    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
    [kona_organiser.3mf, kona_organiser.step, kona_organiser.stl]
2026-09-27 rear: v9 - key fob pocket 58 mm deep
    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
    [kona_organiser.3mf, kona_organiser.step, kona_organiser.stl]
2026-09-27 rear: v10 - fob pocket straight sided, 58 x 43.5; dimensioned top view
    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
    [kona_organiser.3mf, kona_organiser.step, kona_organiser.stl]
2026-09-27 rear: v11 - fob pocket 58 x 40
    Original files as delivered. render.py and dims.py are the session's helper scripts, with paths made local.
    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
    [kona_organiser.3mf, kona_organiser.step, kona_organiser.stl]
2026-10-12 front: v1 - tongue in the narrow slot, lip balm cradle, fob pocket
    Original files as delivered, with the four photos of the front strip. Strip width (44 mm) is assumed until measured.
    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
    [kona_front_organiser.3mf, kona_front_organiser.step, kona_front_organiser.stl]
2026-10-13 docs: front v2 test-print feedback, record and decisions
    Claude-Session: https://claude.ai/code/session_018Suzw5HdBCptc5sUjjfBD2
2026-10-13 front: v2 - 161.6 long (caliper + 5), 13 tall throughout, no finger well, nub in fob pocket
    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
    [kona_front_organiser.3mf, kona_front_organiser.step, kona_front_organiser.stl]
2026-10-16 docs: front v3 test-print feedback, record and decisions
    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
2026-10-16 front: v3 - tab 2 mm narrower, 2 mm shorter, open half-cylinder balm trough with finger space, fob floor tilted right
    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
    [kona_front_organiser.3mf, kona_front_organiser.step, kona_front_organiser.stl]
2026-10-16 front: v4 - ends taper 10 deg, grip notch both sides of balm trough, fob floor flat
    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
    [kona_front_organiser.3mf, kona_front_organiser.step, kona_front_organiser.stl]
2026-10-16 front: v6 - finger space removed, trough walls are outer walls, shared wall with fob pocket
    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
    [kona_front_organiser.3mf, kona_front_organiser.step, kona_front_organiser.stl]
2026-10-16 front: v5 - angled right end, balm on cupholder side with finger space at panel, narrow body beside balm, 5 deg taper
    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
    [kona_front_organiser.3mf, kona_front_organiser.step, kona_front_organiser.stl]
2026-10-16 docs: front v6 print session record and decisions
    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
