tristancode/kona-3d-prints/reference/photos/front-strip-01.jpg

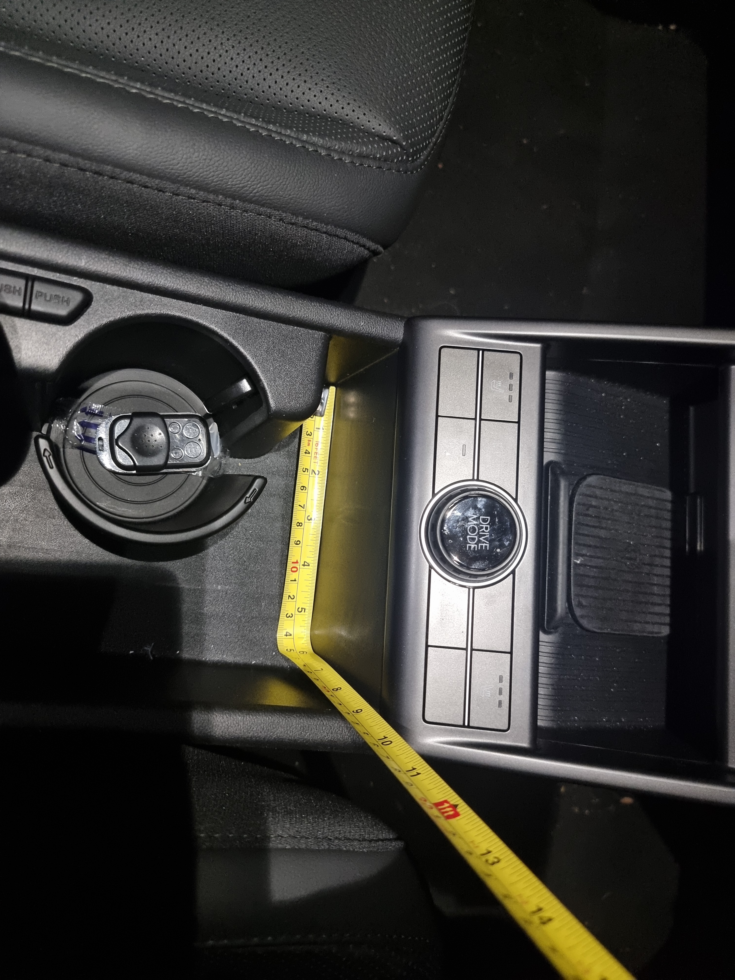
reference/photos/front-strip-01.jpg
